curiouselectric/SegOMatic/README.md

# SegOMatic
Design files for a 7 segment LED DIY kit
