curiouselectric/SegOMatic/LED 7 seg Instructions/2015_12_3_Hole Layout.pdf

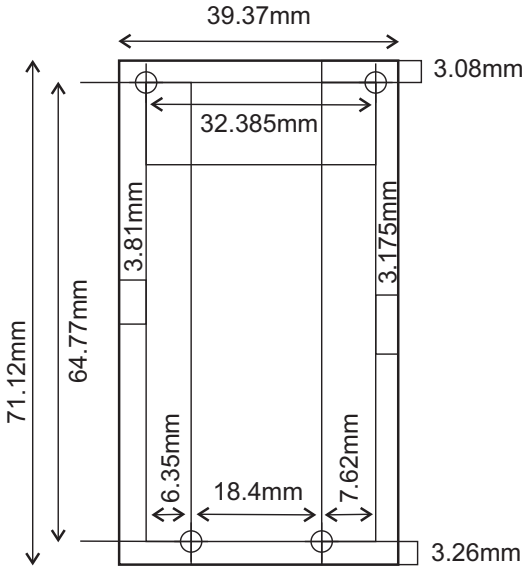
[picture p23: figure]
