curiouselectric/SegOMatic/LED 7 seg PCB/LED 7 Seg PCB_2016/LED_7_seg_display_2016.kicad_pcb

## KiCad design LED 7 seg PCB/LED 7 Seg PCB_2016/LED_7_seg_display_2016.kicad_pcb (2017-03-24)

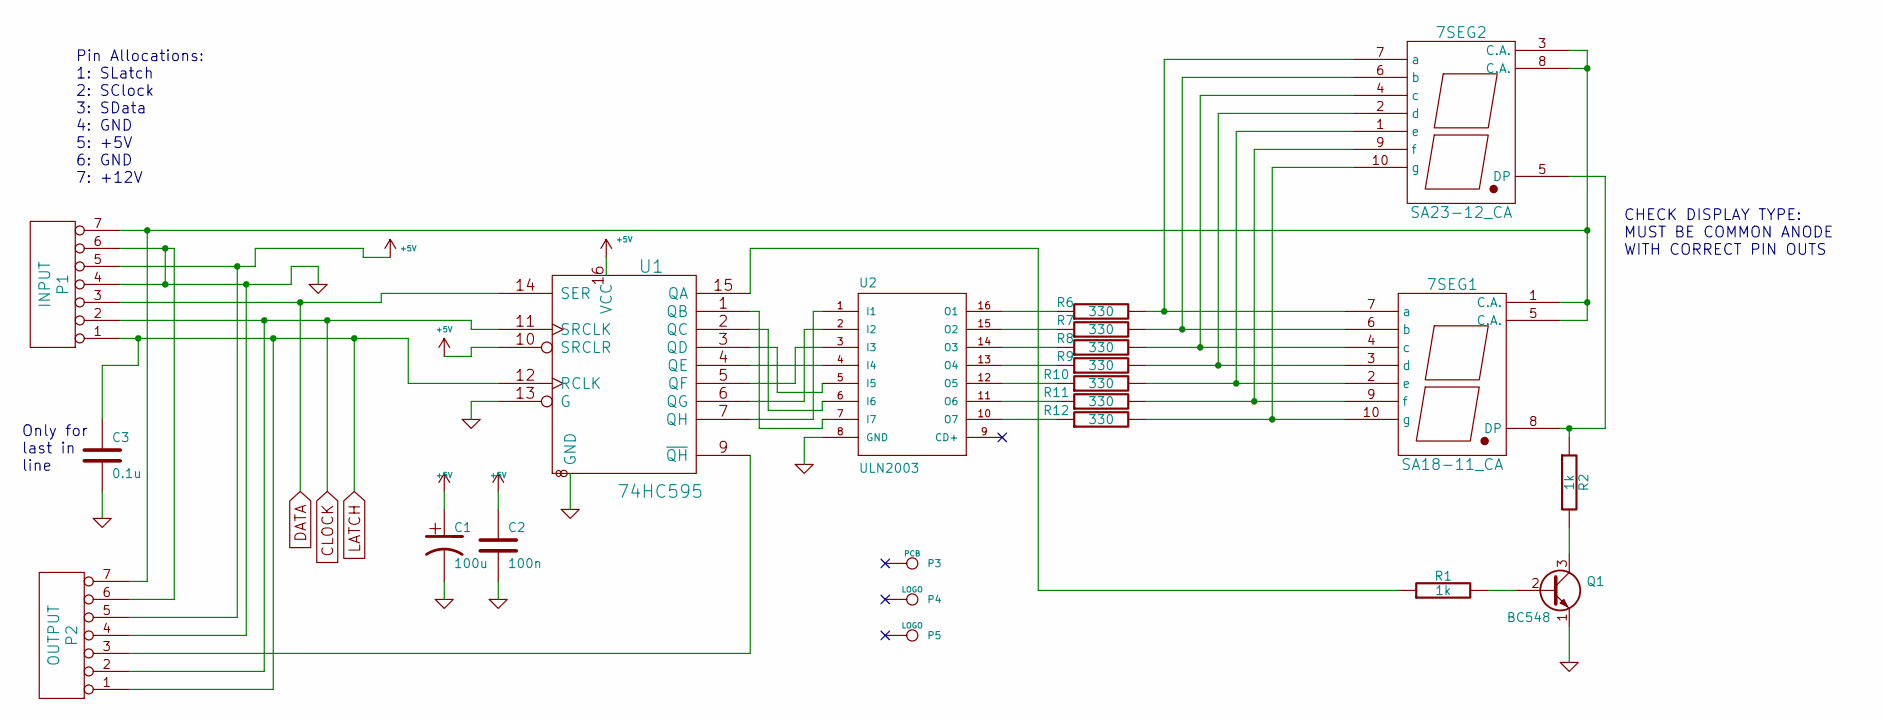
[picture p24: schematic LED_7_seg_display_2016.sch]

Parts:
7SEG1: SA18-11_CA; 7SEG_CA_SA18-11
7SEG2: SA23-12_CA; 7SEG_CC_2_3INCH
C1: 100u; C_Radial_D6.3_L11.2_P2.5
C2: 100n; C1_wide_lg_pad
C3: 0.1u; C1_wide_lg_pad
P1: INPUT; TH_SIL-7_large_pads
P2: OUTPUT; TH_SIL-7_large_pads
P3: PCB; PCB_40x85mm
P4: LOGO; CuriousElectric_globe_10mm
P5: LOGO; TCEC_Words_13mm
Q1: BC548; TH_TO92-EBC_large_pad
R1, R2: 1k; TH_Resistor_1
R6, R7, R8, R9, R10, R11, R12: 330; TH_Resistor_1
U1: 74HC595; TH_DIP-16__300_ELL
U2: ULN2003; TH_DIP-16__300_ELL

Connections:
+5V: C1.1, C2.1, P1.5, P2.5, U1.10 (SRCLR), U1.16 (VCC)
CLOCK: P1.2, P2.2, U1.11 (SRCLK)
DATA: P1.3, U1.14 (SER)
GND: C1.2, C2.2, C3.2, P1.4, P1.6, P2.4, P2.6, Q1.1 (E), U1.8 (GND), U1.13 (G), U2.8 (GND)
LATCH: C3.1, P1.1, P2.1, U1.12 (RCLK)
unnamed: 7SEG1.1 (C.A.), 7SEG1.5 (C.A.), 7SEG2.3 (C.A.), 7SEG2.8 (C.A.), P1.7, P2.7
unnamed: 7SEG1.2 (e), 7SEG2.1 (e), R10.2
unnamed: 7SEG1.3 (d), 7SEG2.2 (d), R9.2
unnamed: 7SEG1.4 (c), 7SEG2.4 (c), R8.2
unnamed: 7SEG1.6 (b), 7SEG2.6 (b), R7.2
unnamed: 7SEG1.7 (a), 7SEG2.7 (a), R6.2
unnamed: 7SEG1.8 (DP), 7SEG2.5 (DP), R2.1
unnamed: 7SEG1.9 (f), 7SEG2.9 (f), R11.2
unnamed: 7SEG1.10 (g), 7SEG2.10 (g), R12.2
unnamed: P2.3, U1.9 (~QH)
unnamed: Q1.2 (B), R1.2
unnamed: Q1.3 (C), R2.2
unnamed: R1.1, U1.15 (QA)
unnamed: R6.1, U2.16 (O1)
unnamed: R7.1, U2.15 (O2)
unnamed: R8.1, U2.14 (O3)
unnamed: R9.1, U2.13 (O4)
unnamed: R10.1, U2.12 (O5)
unnamed: R11.1, U2.11 (O6)
unnamed: R12.1, U2.10 (O7)
unnamed: U1.1 (QB), U2.7 (I7)
unnamed: U1.2 (QC), U2.6 (I6)
unnamed: U1.3 (QD), U2.5 (I5)
unnamed: U1.4 (QE), U2.4 (I4)
unnamed: U1.5 (QF), U2.3 (I3)
unnamed: U1.6 (QG), U2.2 (I2)
unnamed: U1.7 (QH), U2.1 (I1)

Notes on the sheet:
CHECK DISPLAY TYPE: MUST BE COMMON ANODE WITH CORRECT PIN OUTS
Pin Allocations: 1: SLatch 2: SClock 3: SData 4: GND 5: +5V 6: GND 7: +12V
Only for last in line

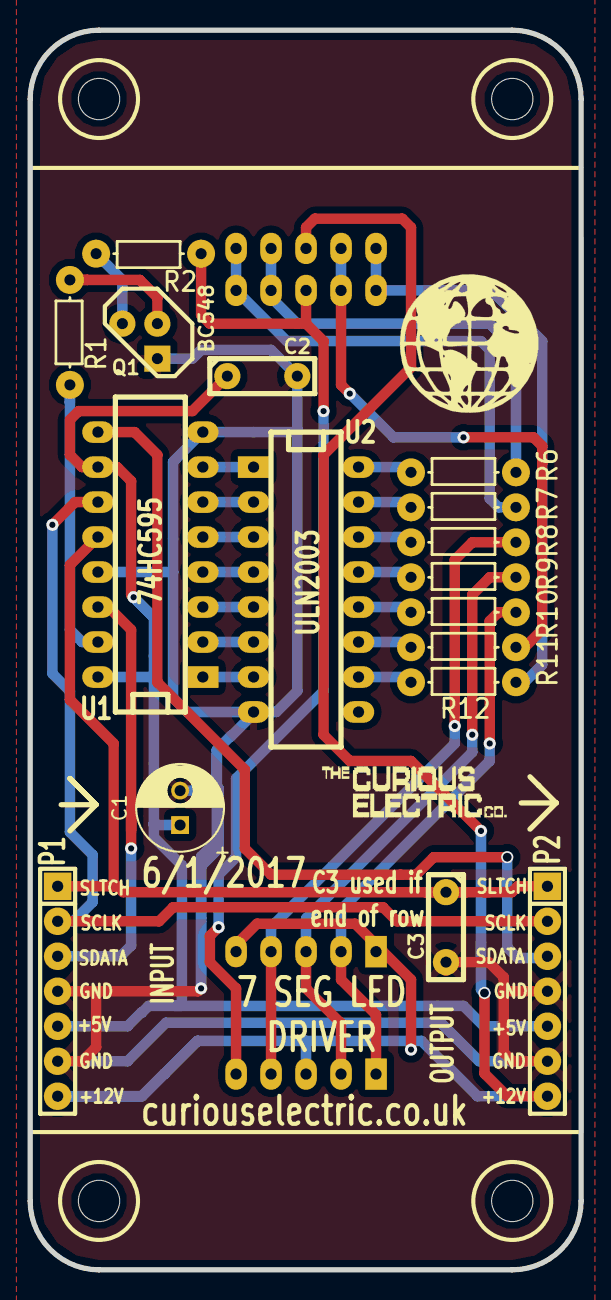
[picture p25: board LED_7_seg_display_2016.kicad_pcb from above]

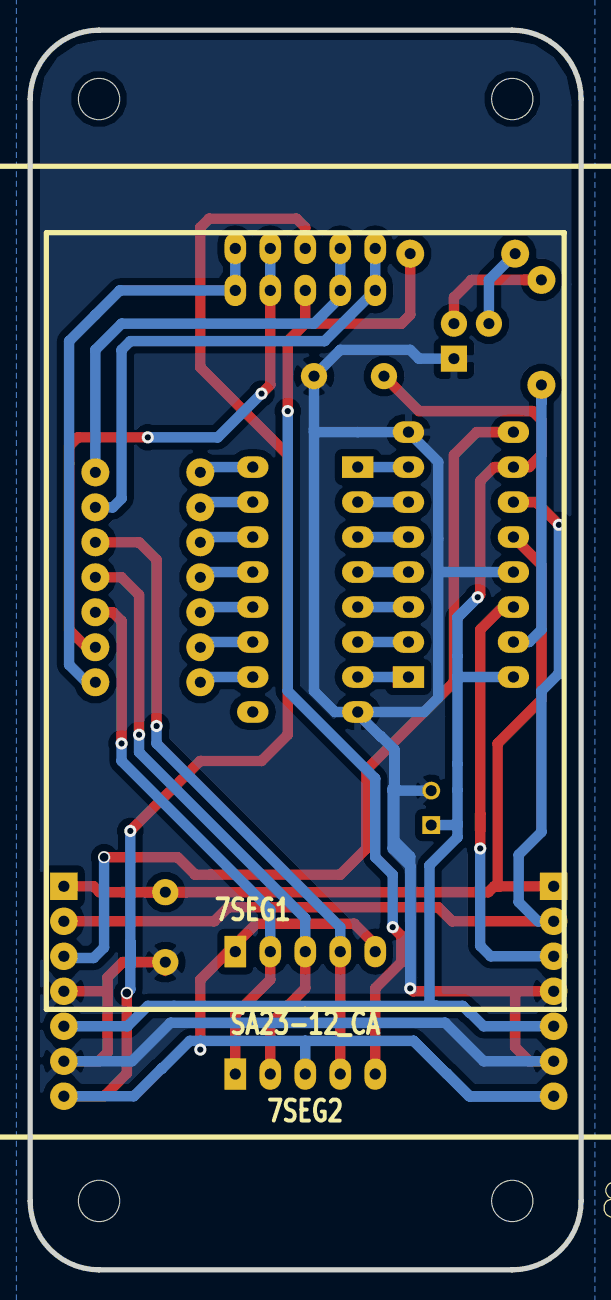
[picture p26: board LED_7_seg_display_2016.kicad_pcb from below]

Board: 2 copper layers, 40.0 x 90.0 mm, 22 parts (2 on the bottom side), 32 nets.
