curiouselectric/SegOMatic/(commit log)

2015-11-30 Added Design Files and Instructions
    [Hole Layout.dxf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]
2015-12-03 Initial files
    2015 12 3
    [Hole Layout.dxf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]
2017-03-24 Updated new PCB design
    [LED_7_seg_display_2013-B_Mask.gbs, LED_7_seg_display_2013-Back.gbl, LED_7_seg_display_2013-Edge_Cuts.gbr, LED_7_seg_display_2013-F_Mask.gts, LED_7_seg_display_2013-F_SilkS.gto, LED_7_seg_display_2013-Front.gtl, LED_7_seg_display_2013.drl, LED_7_seg_display_2016-B.Mask.gbs]
